roboticsoutreach/Freshers-Bot-HW/README.md

# Freshers-Bot-HW
hardware files used for the freshers bot
