roboticsoutreach/Freshers-Bot-HW/BOM.xlsx

part name | QTY per board | price per part | total per board | link
AA battery holder | 3 | 0.42 | 1.26 | https://uk.rs-online.com/web/p/battery-holders-mounts/6119576/
PMOS | 4 | 0.221 | 0.884 | https://uk.rs-online.com/web/p/mosfets/8628782/ | minimum order of 20
NMOS | 4 | 0.07 | 0.28 | https://uk.rs-online.com/web/p/mosfets/7192787/ | currently on back order, should a possible alternative is https://uk.rs-online.com/web/p/mosfets/7192777/
quad and | 1 | 0.091 | 0.091 | https://uk.rs-online.com/web/p/logic-gates/6881521/ | minimum order of 5
3mm LED | 2 |  | 1 |  | Already have lots
Attiny | 1 | 0.638 | 0.638 | https://uk.rs-online.com/web/p/microcontrollers/1656452/
headers | 7 | 0.118 | 0.826 | https://uk.rs-online.com/web/p/pcb-headers/2518092/ | minimum order of 25
100n cap | 4 | 0.014 | 0.056 | https://uk.rs-online.com/web/p/mlccs-multilayer-ceramic-capacitors/4646688/
240r resistor | 2 | 0.282 | 0.564 | https://uk.rs-online.com/web/p/surface-mount-fixed-resistors/8667351/
motor | 2 | 1 | 2 | https://www.amazon.co.uk/Rabi-15000-16500RPM-Electric-Science-Experiments/dp/B075Q444K9
 |  |  | 0
 |  |  | 0
 |  |  | 0
 |  |  | 0
 |  |  | 0
 |  |  | 7.599
