roboticsoutreach/Freshers-Bot-HW/freshers project.kicad_pcb

## KiCad design freshers project.kicad_pcb (2019-09-17)

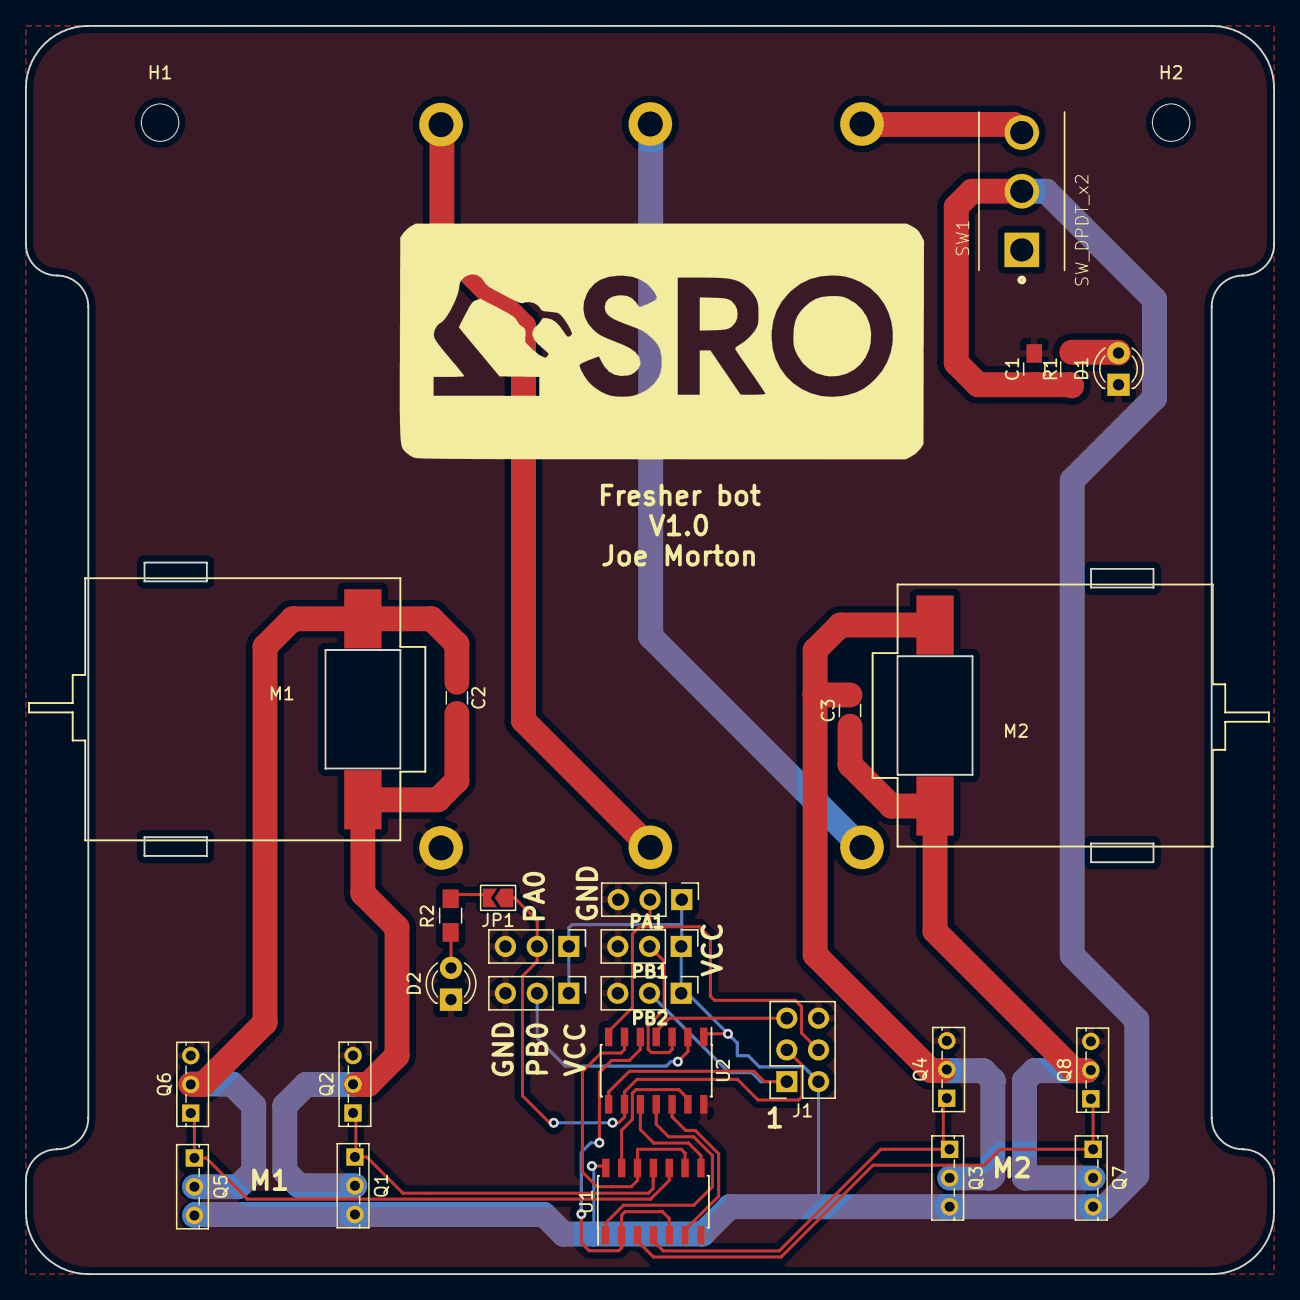
[picture p1: board freshers project.kicad_pcb from above]

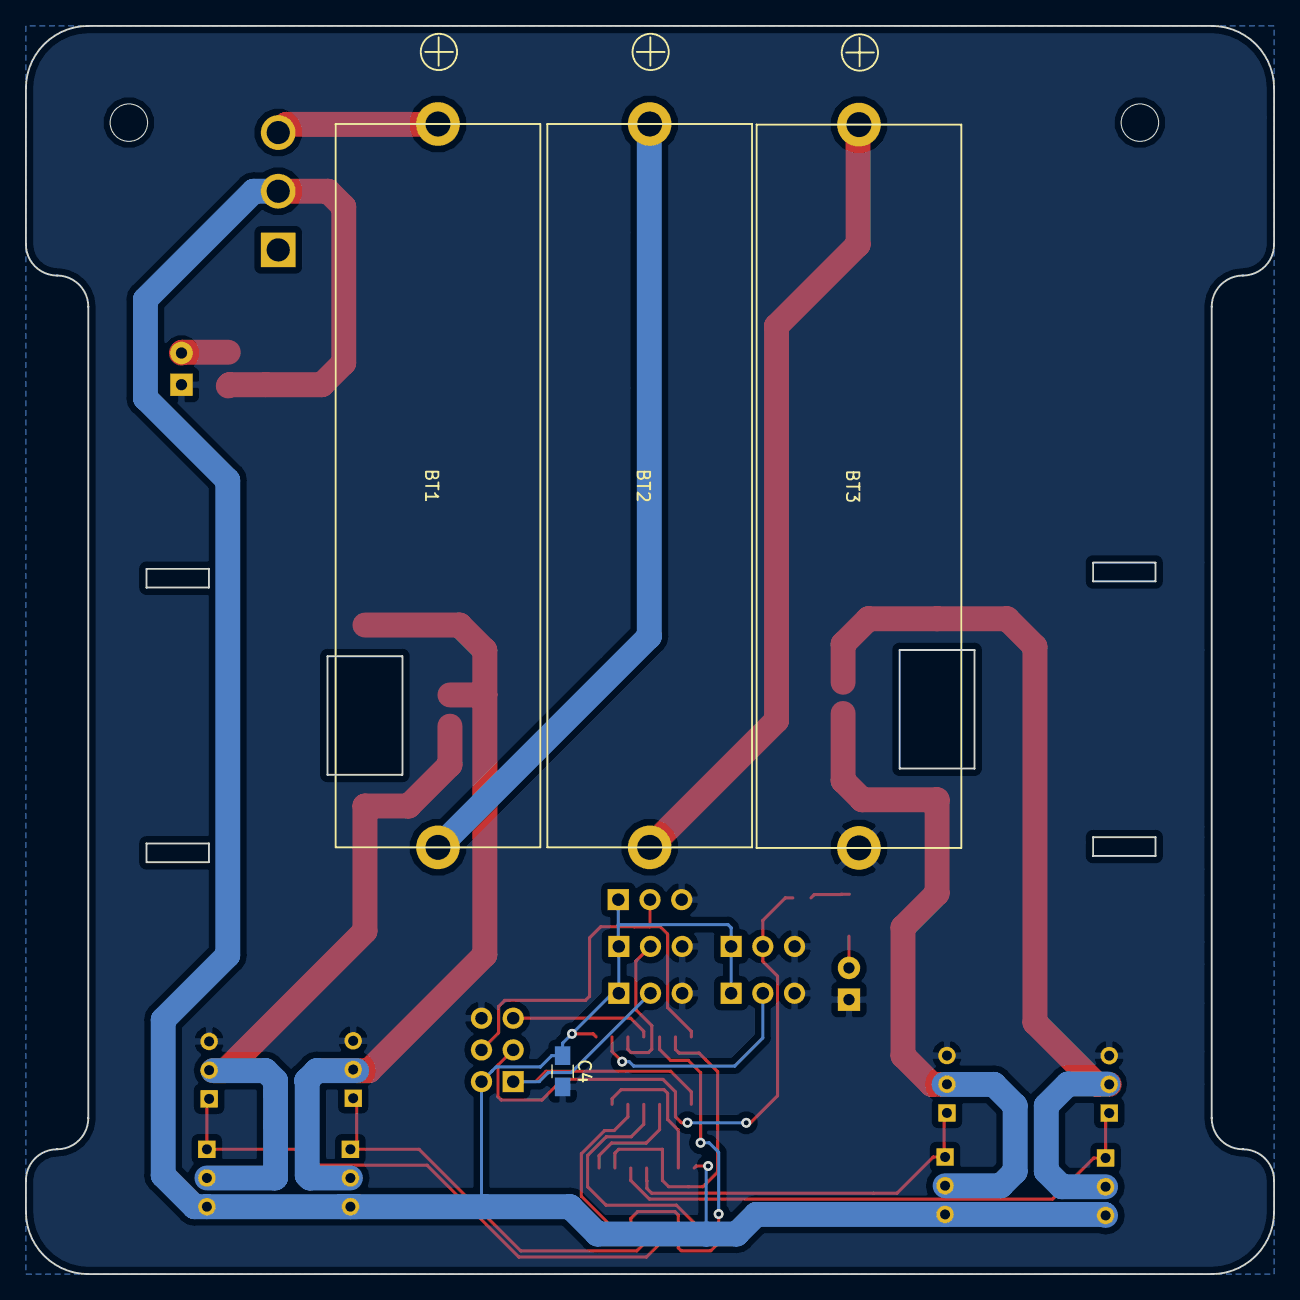
[picture p2: board freshers project.kicad_pcb from below]

Board: 2 copper layers, 100.0 x 100.0 mm, 33 parts (4 on the bottom side), 28 nets.

Parts:
BT1, BT2, BT3: Battery_Cell; AA battery holder
C1, C2, C3, C4: C; C_0805_HandSoldering
D1, D2: LED; LED_D3.0mm
H1, H2: MountingHole; MountingHole_3mm
J1: Conn_02x03_Odd_Even; Socket_Strip_Straight_2x03_Pitch2.54mm
J2, J3, J4, J5, J6: Conn_01x03; Socket_Strip_Straight_1x03_Pitch2.54mm
JP1: Jumper; SolderJumper-2_P1.3mm_Open_TrianglePad1.0x1.5mm
M1, M2: Motor_DC; SMDmotorMount
Q1, Q3, Q5, Q7: Q_PMOS_GDS; TO-251_IPAK_Vertical
Q2, Q4, Q6, Q8: Q_NMOS_GDS; TO-251_IPAK_Vertical
R1, R2: R; R_0805_HandSoldering
SW1: SW_DPDT_x2; TE_A101SYCQ04
U1: 4081; SOIC-14_3.9x8.7mm_Pitch1.27mm
U2: ATtiny24-20SSU; SOIC-14_3.9x8.7mm_Pitch1.27mm

Connections:
GND: BT3.2, C1.2, C4.2, D1.1, D2.1, J1.6, J2.3, J3.3, J4.3, J5.3, J6.3, Q2.3, Q4.3, Q6.3, Q8.3, U1.7, U2.14
M1A: U1.13, U2.13
M1B: U1.8, U2.10
M1PWM: U1.9, U1.12, U2.6
M2A: U1.6, U2.12
M2B: U1.1, U2.11
M2PWM: U1.2, U1.5, U2.5
MISO: J1.1, J6.2, U2.8
MOSI: J1.4, J4.2, U2.7
unnamed: BT1.1, SW1.3
unnamed: BT1.2, BT2.1
unnamed: BT2.2, BT3.1
unnamed: C2.1, M1.1, Q5.2, Q6.2
unnamed: C2.2, M1.2, Q1.2, Q2.2
unnamed: C3.1, M2.1, Q7.2, Q8.2
unnamed: C3.2, M2.2, Q3.2, Q4.2
unnamed: D1.2, R1.2
unnamed: D2.2, R2.2
unnamed: JP1.2, R2.1
unnamed: Q1.1, Q2.1, U1.11
unnamed: Q3.1, Q4.1, U1.4
unnamed: Q5.1, Q6.1, U1.10
unnamed: Q7.1, Q8.1, U1.3
PA4: J1.3, J3.2, JP1.1, U2.9
PB0: J2.2, U2.2
PB1: J5.2, U2.3
RESET: J1.5, U2.4
VCC: C1.1, C4.1, J1.2, J2.1, J3.1, J4.1, J5.1, J6.1, Q1.3, Q3.3, Q5.3, Q7.3, R1.1, SW1.2, U1.14, U2.1
